Apoll011/LIC-TicketMachine/TicketMachine_LEIC23_G03.pdf

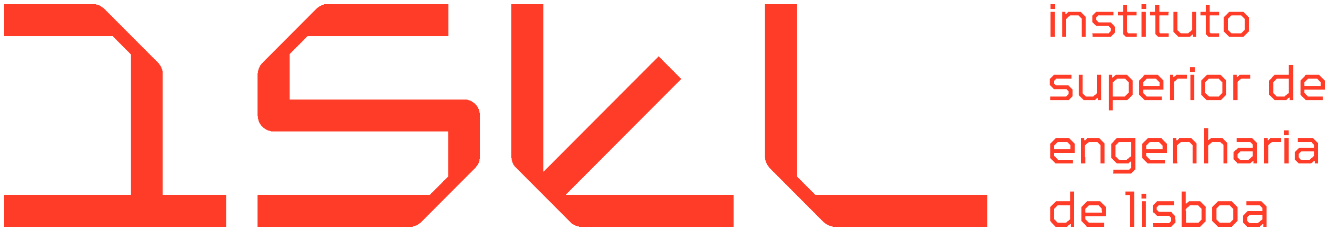
[picture p1: figure]

# Licenciatura em Engenharia Informática e de Computadores

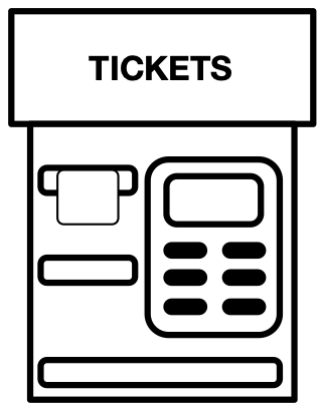
[picture p2: figure]

# MÁQUINA DE VENDA DE BILHETES

# (Ticket Machine)

## Projeto

de

## Laboratório de Informática e Computadores

## 2025 / 2026 verão

## Tiago Inês, Tiago Pedroso, Tomás Ferreira

## 05 de julho de 2026

# Conteúdo

1 Descrição | 1
2 Arquitetura do Sistema | 3
3 Resultados Experimentais | 8
4 Conclusões | 9
5 Trabalho Futuro | 9
Referências | 11
A Ticket Machine - Hardware | 12
B Ticket Machine - Software (Control) | 20

i

# Lista de Figuras

1 | Diagrama de blocos da Máquina de Venda de Bilhetes (Ticket Machine) | | 1
2 | Arquitetura do sistema que implementa a máquina de venda de bilhetes (Ticket
Machine) | | 3
3 | Diagrama de blocos do Keyboard Reader | | 4
4 | Bloco Coin Acceptor | | 5
a | Diagrama de blocos | | 5
b | Diagrama temporal | | 5
5 | Diagrama de blocos do módulo Port Expander LCD (PELCD) | | 5
6 | Diagrama de blocos do módulo Port Expander Ticket Dispenser (PETD) . . . . | 6
7 | Diagrama lógico da Máquina de Venda de Bilhetes (Ticket Machine) | | 6

# Lista de Tabelas

1 | Codificação do valor facial das moedas | | 5
2 | Atribuição de pinos do ficheiro TicketMachine.vhd [4] | | 17
3 | Atribuição de variáveis para o USBPort | | 19

# Lista de Algoritmos

1 | Ticket Machine Main Module | | 12
2 | Ticket Machine Application | | 20
3 | TUI | | 28
4 | Coin Acceptor | | 36
5 | Coin Deposit | | 37
6 | Stations | | 38
7 | File Access | | 38

ii

Laboratório de Informática e Computadores 2025/2026 verão Máquina de Venda de Bilhetes (Ticket Machine)

# 1 Descrição

## Este projeto implementa uma máquina de venda de bilhetes (Ticket Machine), que permite a

aquisição de bilhetes de comboio. O percurso é definido pela estação de origem, local de compra do bilhete e pela seleção do destino digitando o identificador da estação ou através das teclas ↑ e ↓, sendo exibido no ecrã além do identificador da estação de destino o preço e o tipo de bilhete (ida ou ida/volta). A ordem de aquisição é dada através da pressão da tecla de confirmação, sendo impressa uma unidade do bilhete exibido no ecrã. A máquina não realiza trocos e só aceita

## moedas de: 0,05e; 0,10e; 0,20e; 0,50e; 1,00e; e 2,00e. Para além do modo de Dispensa, o

## sistema tem mais um modo de funcionamento designado por Manutenção, que é ativado por

## uma chave de manutenção. Este modo permite o teste da máquina de venda de bilhetes, bem

como permite iniciar e consultar os contadores de bilhetes e moedas. A máquina de venda de bilhetes é constituída pelo sistema de gestão (designado por Control na Figura 1) e pelos seguintes periféricos: um teclado de 16 teclas, um moedeiro (designado por Coin Acceptor ), um ecrã Liquid Cristal Display (LCD) de duas linhas de 16 caracteres, um mecanismo de dispensa de bilhetes (designado por Ticket Dispenser ) e uma chave de manutenção (designada por M ) que define se

## a máquina de venda de bilhetes está em modo de Manutenção, conforme o diagrama de blocos

apresentado na Figura 1.

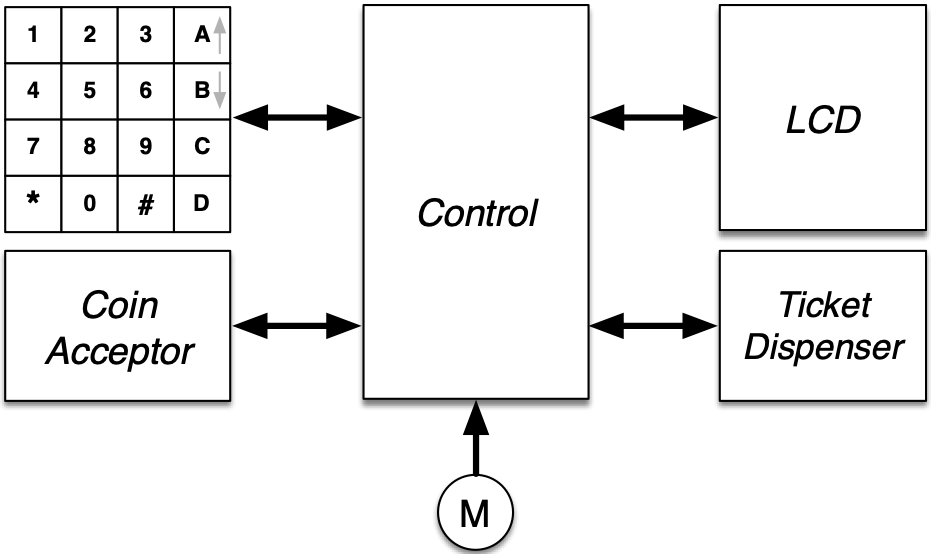
[picture p3: figure]

### Figura 1: Diagrama de blocos da Máquina de Venda de Bilhetes (Ticket Machine)

## Sobre o sistema podem-se realizar as seguintes ações em modo Venda:

## - Consulta e venda A consulta de um bilhete é realizada digitando o identificador da

estação de destino ou listando-a através das teclas ↑ e ↓. O processo de compra do bilhete inicia-se premindo a tecla ‘#’. Durante a inserção do respetivo valor monetário, é possível alterar o tipo de bilhete (ida ou ida/volta) premindo a tecla ‘∗’, com a consequente alteração

## do preço da viagem afixado no LCD, duplicando o valor no caso de ida/volta. Durante a

## compra ficam afixados no LCD as informações referentes ao bilhete pretendido até que o

## mecanismo de impressão de bilhetes confirme que a impressão já foi realizada e a recolha

## do bilhete efetuada. A compra pode ser cancelada premindo a tecla ‘#’, devolvendo as

moedas inseridas.

1

## Sobre o sistema podem-se realizar as seguintes ações em modo Manutenção:

## - Teste – Esta opção do menu permite realizar um procedimento de consulta e venda de

## um bilhete, sem introdução de moedas e sem esta operação ser contabilizada como uma

aquisição.

- Consulta Bilhetes – Premindo a tecla ’A’, em seguida através das teclas ↑ e ↓, visualizam os contadores do número de bilhetes vendidos.

## - Consulta Moedas – Premindo a tecla ’B’, em seguida através das teclas ↑ e ↓, visualizam

os contadores das moedas no cofre.

## - Iniciar os contadores de moedas e bilhetes – Premindo a tecla ’C’ e em seguida a

tecla ’∗’, o sistema de gestão coloca os contadores de moedas e bilhetes a zero, iniciando um novo ciclo de contagem.

## - Desligar – Premindo a tecla ’D’ permite desligar o sistema, que encerra apenas após a

## confirmação do utilizador, ou seja, o programa termina e as estruturas de dados, contendo

## a informação dos contadores de moedas e da lista de bilhetes vendidos, são armazena-

## das de forma persistente em dois ficheiros de texto. A informação em cada ficheiros deve

## estar organizada por linha, em que os campos de dados são separados por “;”, com o respe-

## tivo formato: ’COIN_V ALUE; NUMBER_COINS’ (valor facial; número de moedas) e

## ’P RICE; SOLD_T ICKET S; ST AT ION_NAME’ (preço; número de bilhetes vendidos

## para a estação; nome da estação). Os dois ficheiros devem ser carregados para o sistema

no seu processo de arranque.

Nota: A inserção de informação através do teclado tem o seguinte critério: i) se não for premida

## nenhuma tecla num intervalo de cinco segundos o comando em curso é abortado; ii) quando o

dado a introduzir é composto por mais que um dígito, são considerados apenas os últimos dígitos, a inserção realiza-se do dígito de maior peso para o de menor peso.

2

# 2 Arquitetura do Sistema

## O sistema implementa uma solução híbrida de hardware e software, como apresentado no dia-

grama de blocos da Figura 2. A arquitetura proposta é constituída por cinco módulos principais:

## i) um leitor de teclado, designado por Keyboard Reader ; ii) um módulo de interface com o

## LCD, designado por Port Expander LCD (PELCD); iii) um módulo de interface com o meca-

nismo de dispensa de bilhetes (Ticket Dispenser ), designado por Port Expander Ticket Dispenser (PETD); iv) um moedeiro, designado por Coin Acceptor ; e v) um módulo de controlo, designado por Control.
Os módulos i), ii) e iii) deverão ser implementados em hardware, o moedeiro (iv) será emu-lado utilizando quatro interruptores e três LED, enquanto o módulo de controlo (v) deverá ser implementado em software, descrito em linguagem Kotlin e executado num PC.

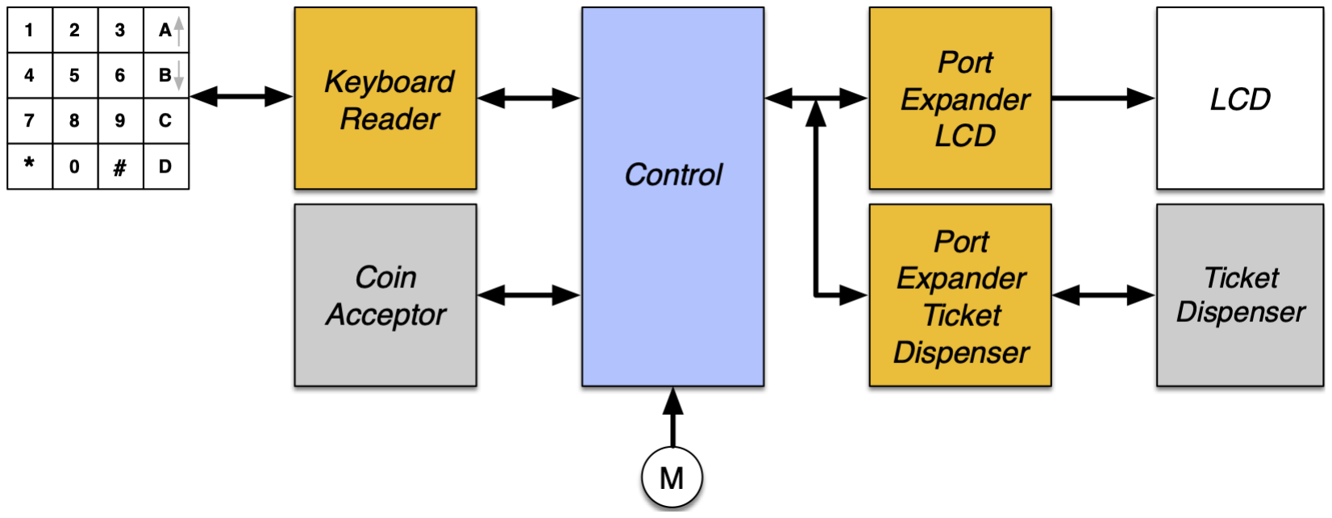
[picture p4: figure]

Figura 2: Arquitetura do sistema que implementa a máquina de venda de bilhetes (Ticket Machine)

O módulo Keyboard Reader é responsável pela descodificação do teclado matricial de 16 teclas, determinando qual a tecla pressionada e disponibilizando o seu código, com quatro bits, ao módulo Control. Caso este não esteja disponível para o receber imediatamente, o código da tecla é armazenado internamente, até ao limite de dezoito (18) códigos. O módulo Control processa os dados e envia a informação a apresentar no LCD através do módulo PELCD. O Ticket Dispenser

## é atuado pelo módulo Control, através do módulo PETD. Por forma a minimizar o número de

## interligações, a comunicação entre o módulo Control e os módulos PELCD e PETD é realizada

através de um protocolo série.

## 2.1 Keyboard Reader

O módulo Keyboard Reader [1] é constituído por três blocos principais: i) o descodificador de teclado (Key Decode); ii) o bloco de armazenamento (designado por Ring Buffer ); e iii) o bloco de entrega ao consumidor (designado por Key Transmitter ). Neste caso o módulo Control, implementado em software, é a entidade consumidora.

## 2.1.1 Ring Buffer

O bloco Ring Buffer implementa uma fila FIFO de 16 posições de 4 bits, responsável por desa-coplar o ritmo de produção de teclas (lado do Key Decode) do ritmo de consumo (lado do Key

3

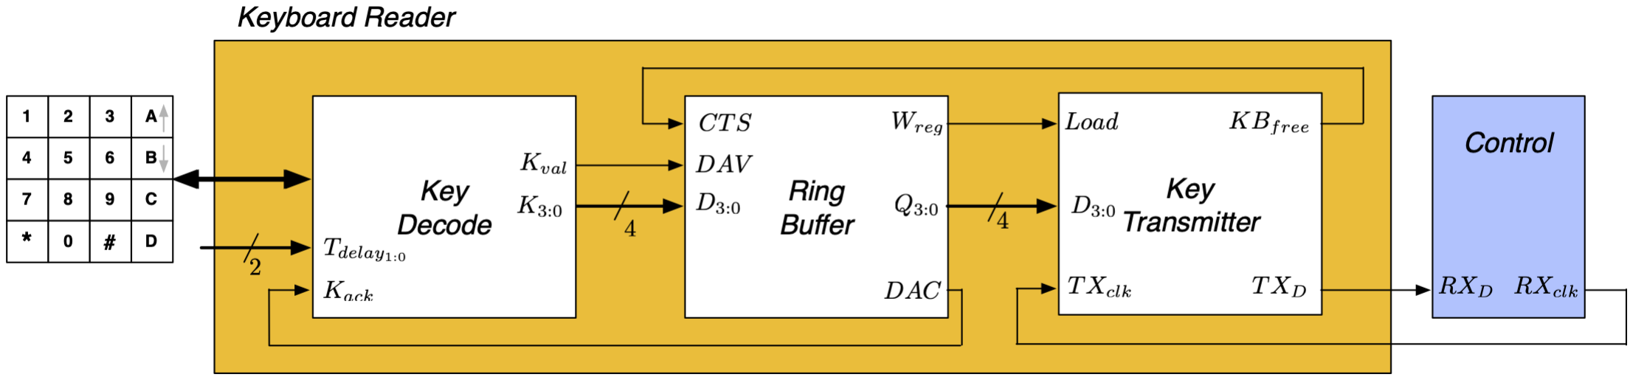
[picture p5: figure]

### Figura 3: Diagrama de blocos do Keyboard Reader

Transmitter ). A sua arquitectura, representada na Figura 3, é composta por três sub-blocos:

## - RAM — memória de 16 palavras de 4 bits, construída estruturalmente a partir de 16

registos Reg endereçados por um descodificador DecoderBuffer. A leitura é combinatória; a escrita é síncrona e controlada pelo sinal wr.

## - MAC (Memory Address Control) — mantém dois apontadores de 4 bits, putIndex (es-

## crita) e getIndex (leitura), cada um implementado com um somador e um registo. Um

## sub-bloco RAMEF conta o número de elementos presentes e gera os sinais full e empty. O

## sinal putNget selecciona, via MUX4, qual dos dois apontadores é apresentado à RAM em

cada ciclo.

## - RBC (Ring Buffer Control) — máquina de estados que arbitra o acesso à RAM entre as

operações de escrita (proveniente do Key Decode via DAV) e de leitura (solicitada pelo Key Transmitter via CTS). A escrita é confirmada ao produtor através do sinal DAC; a leitura é sinalizada ao Key Transmitter através do sinal Wreg.

O protocolo de escrita segue o handshake DAV/DAC definido no enunciado: o Key Decode activa DAV e mantém os dados estáveis; o Ring Buffer escreve em memória, activa DAC e aguarda que DAV baixe antes de regressar ao estado de espera. A leitura é iniciada pelo Key Transmitter através de CTS: o Ring Buffer coloca os dados de getIndex na saída Q, pulsa Wreg para que o Key Transmitter os latche, e incrementa getIndex.

## 2.2 Coin Acceptor

O módulo Coin Acceptor implementa a interface com o moedeiro, sinalizando ao módulo Control

## que o moedeiro recebeu uma moeda através da ativação do sinal Coin, o valor monetário da

moeda inserida é codificado em Coinid2:0 , conforme a codificação apresentada na Tabela 1. A

## entidade consumidora informa o Coin Acceptor que já contabilizou a moeda ativando o sinal

accept, conforme apresentado no diagrama temporal da Figura 4b. O Control pode devolver as moedas inseridas no moedeiro através da ativação do sinal eject durante dois segundos, ou reco-lher as moedas presentes no moedeiro através da ativação do sinal collect durante dois segundos.

4

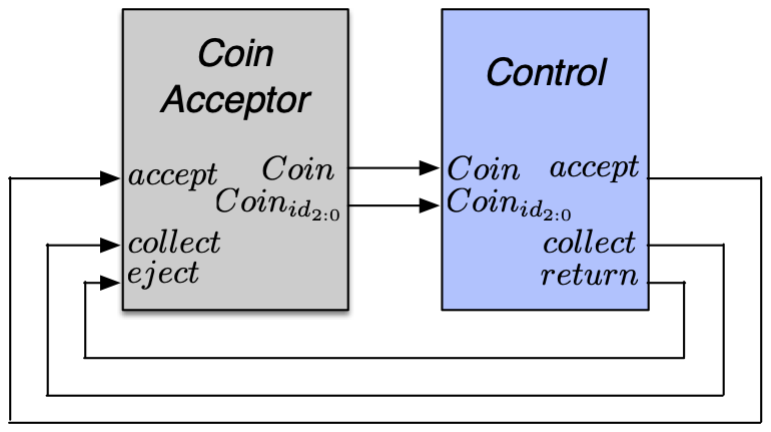
[picture p6: figure]

(a) Diagrama de blocos | (b) Diagrama temporal

### Figura 4: Bloco Coin Acceptor

### Tabela 1: Codificação do valor facial das moedas

Moeda [e] | Codificação [Cid2Cid1Cid0]
0,05 | 000
0,10 | 001
0,20 | 010
0,50 | 011
1,00 | 100
2,00 | 101

## 2.3 Port Expander LCD

## O módulo Port Expander LCD [2] (PELCD) implementa a interface com o LCD, fazendo a

receção em série da informação enviada pelo módulo de controlo e entregando-a posteriormente ao LCD, conforme representado na Figura 5.

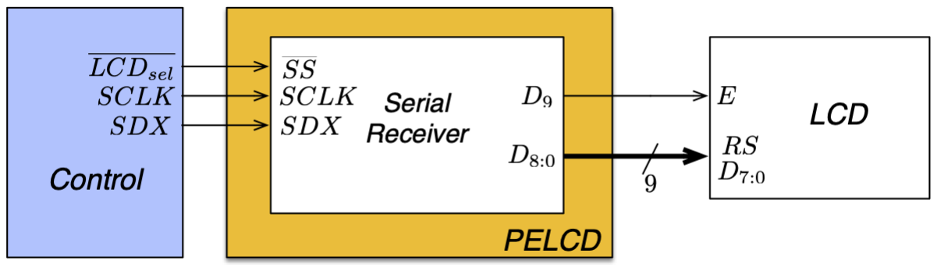
[picture p7: figure]

### Figura 5: Diagrama de blocos do módulo Port Expander LCD (PELCD)

## 2.4 Port Expander Ticket Dispenser

## O módulo Port Expander Ticket Dispenser [3] (PETD) implementa a interface com o mecanismo

de impressão de bilhetes (Ticket Dispenser ), realizando a receção em série da informação enviada

## pelo módulo de controlo e entregando-a posteriormente ao mecanismo, conforme representado

na Figura 6.

5

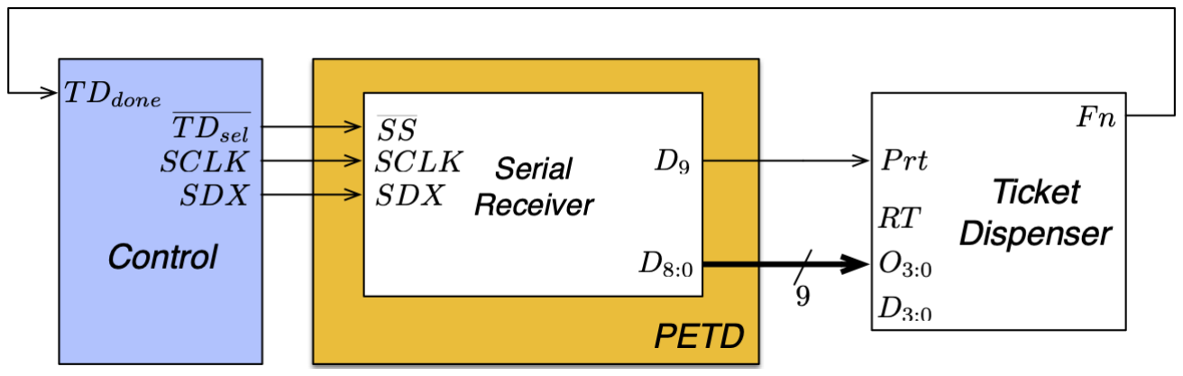
[picture p8: figure]

### Figura 6: Diagrama de blocos do módulo Port Expander Ticket Dispenser (PETD)

## 2.5 Control

## A implementação do módulo Control foi realizada em software, usando a linguagem Kotlin e

seguindo a arquitetura lógica apresentada na Figura 7.

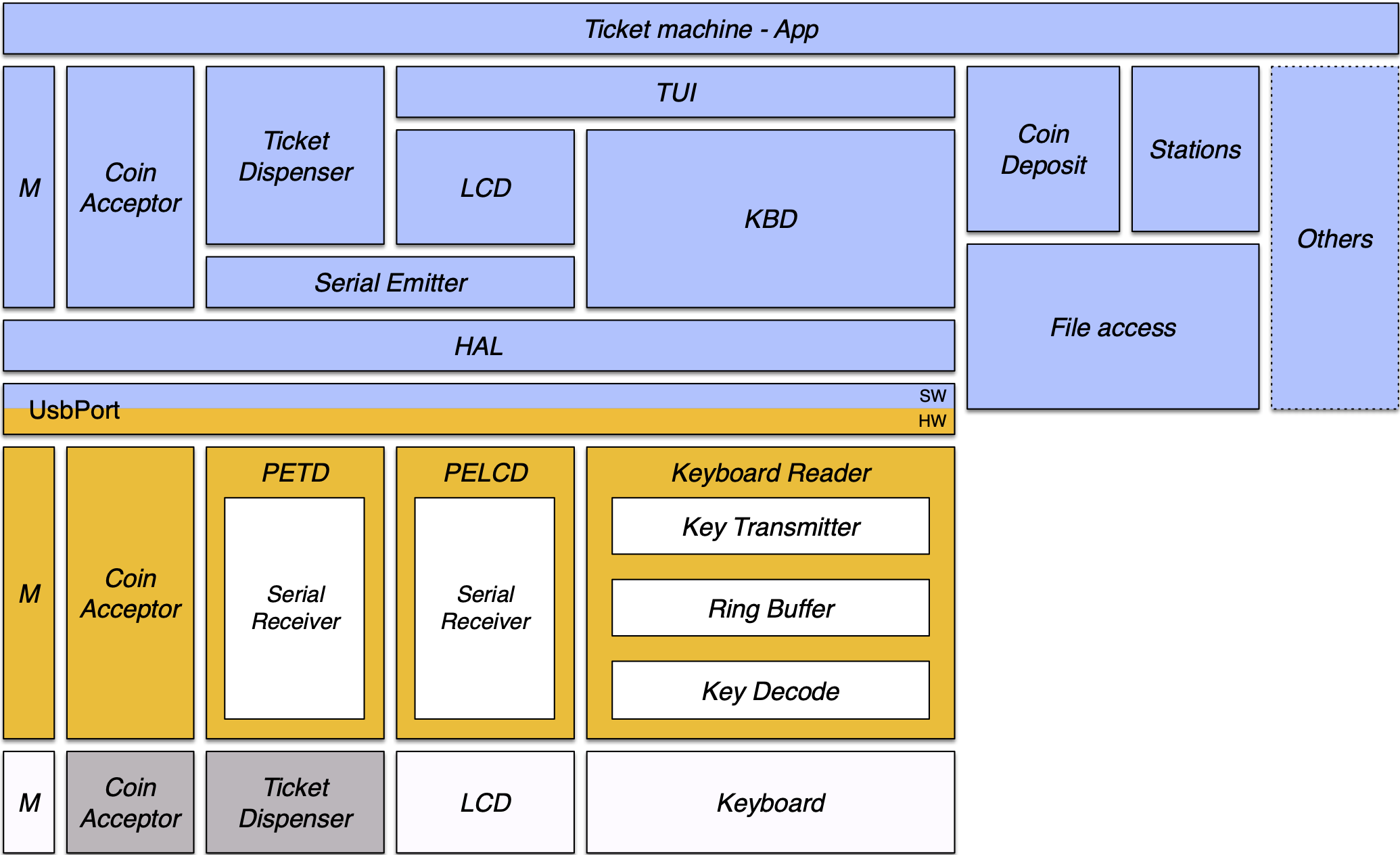
[picture p9: figure]

### Figura 7: Diagrama lógico da Máquina de Venda de Bilhetes (Ticket Machine)

## 2.5.1 Protocolo de comunicação série (software)

## A comunicação entre o módulo Control e os módulos PELCD e PETD é realizada pelo objecto

SerialEmitter, que partilha as linhas SDX (dados) e SCLK (relógio) entre os dois periféricos, diferenciando-os através de sinais de selecção independentes: SSLCD (bit 2 do output port) para o PELCD e SSTD (bit 3) para o PETD.

## O procedimento de envio de uma trama de n bits é o seguinte:

1. Desactivar SCLK e activar o slave select do periférico de destino (transição descendente em SS), assinalando o início de trama.
2. Para cada bit, do LSB para o MSB: colocar o bit em SDX, aguardar a estabilização do sinal,

## activar SCLK e desactivar SCLK. O Serial Receiver no hardware amosta SDX na transição

6

ascendente de SCLK.

## 3. Activar SS (transição ascendente), gerando a condição de fim de trama. Neste momento o

## Hold Register do Serial Receiver captura o conteúdo do Shift Register, tornando os dados

disponíveis nos periféricos.

4. Emitir um pulso de relógio adicional após a subida de SS para garantir que o Hold Register capta correctamente os dados antes que SDX mude de estado.

A trama enviada para o PELCD tem 10 bits no formato [RS, D0, D1, . . . , D7, E], sendo RS o

## primeiro bit transmitido. A trama enviada para o PETD tem igualmente 10 bits no formato

[RT, O0, O1, O2, O3, D0, D1, D2, D3, Prt], onde RT indica o tipo de bilhete (ida/ida e volta), O3:0 e D3:0 são os códigos da estação de origem e de destino, e Prt activa a impressão.
O mapeamento completo entre sinais lógicos e bits do UsbPort está detalhado na Tabela 3 do Apêndice.

7

# 3 Resultados Experimentais

A verificação do sistema foi realizada em duas fases distintas: simulação dos módulos de hardware com recurso ao ModelSim e teste do sistema completo na placa de desenvolvimento DE10-Lite, com o módulo de controlo a correr num PC via ligação USB/JTAG.

## Simulação dos módulos de hardware

Todos os módulos VHDL desenvolvidos foram verificados individualmente através de testbenches dedicados. Os módulos validados incluem os blocos combinatórios e sequenciais da biblioteca comum (FFD, Reg, RAM, AdderSubtrator, CLKDIV), o Keyboard Reader completo (Key_Scan,

## Key_Decode, KeyDecoderFSM, KeyTransmitter, RingBuffer), o módulo PELCD com o respec-

tivo SerialReceiver, e o PETD com o TICKET_DISPENSER.
Os resultados das simulações confirmaram o funcionamento correcto dos protocolos série implementados: a recepção de tramas de 10 bits no PELCD e no PETD produziu os valores esperados nos registos de saída, e o Ring Buffer respeitou a disciplina FIFO com as condições de full/empty correctamente assinaladas.

## Testes na placa

O sistema integrado foi testado na placa DE10-Lite em modo de venda e em modo de manutenção.

## As funcionalidades verificadas incluem:

- Consulta e navegação de destinos através das teclas ↑ e ↓ e por digitação directa do identificador;

## - Inserção de moedas, actualização do montante em falta no LCD e dispensa de bilhete com

activação do sinal collect;

- Cancelamento de compra com devolução das moedas via sinal eject;

## - Acesso ao modo de Manutenção pela chave M e utilização de todas as opções do menu

(Teste, Consulta Bilhetes, Consulta Moedas, Reset e Desligar);

## - Persistência de dados: os contadores de moedas e bilhetes são correctamente guardados

nos ficheiros CoinDeposit.txt e stations.txt e recarregados no arranque seguinte.

8

# 4 Conclusões

O trabalho consistiu no desenvolvimento de uma máquina de venda de bilhetes de comboio,

## implementada numa solução híbrida de hardware e software. A componente de hardware foi

## descrita em VHDL e sintetizada na placa DE10-Lite (FPGA MAX 10), englobando o Keyboard

## Reader, os módulos PELCD e PETD, o Ticket Dispenser e o Coin Acceptor. A componente de

software foi desenvolvida em Kotlin e executada num PC, comunicando com o hardware através da porta virtual JTAG/USB.

## Os resultados experimentais confirmam o funcionamento do sistema em ambos os modos de

## operação definidos no enunciado — modo de Venda e modo de Manutenção — com excepção da

anomalia esporádica no leitor de teclado descrita na secção anterior.
Do ponto de vista das aprendizagens, o projecto foi particularmente relevante em dois domínios:

## Integração hardware/software. A necessidade de coordenar sinais com semântica de nível

(Kval) com protocolos orientados a pulsos (Load/KBfree) evidenciou a importância de uma espe-cificação rigorosa das interfaces entre os dois domínios. A introdução do módulo KeyInterface,

## que resolve o deadlock de handshake entre o Key_Decode e o KeyTransmitter, ilustra como

problemas de integração surgem frequentemente nas fronteiras entre blocos, mesmo quando cada bloco individualmente está correcto.

## Arquitectura em camadas (HAL/TUI ). A separação entre a camada de abstracção de

hardware (HAL), a camada de interface série (SerialEmitter), os periféricos lógicos (LCD, KBD, CoinAcceptor, TicketDispenser) e a lógica aplicacional (App) permitiu desenvolver e testar

## cada módulo de forma independente, reduzindo significativamente o esforço de depuração na

fase de integração. Esta organização, semelhante à de sistemas embebidos reais, demonstrou o valor prático de uma arquitectura em camadas mesmo em projectos de dimensão académica.

# 5 Trabalho Futuro

## No âmbito do desenvolvimento futuro da máquina de venda de bilhetes, existem diversas me-

lhorias que poderiam ser implementadas de forma a enriquecer a experiência do utilizador e aumentar a funcionalidade do sistema.
Uma das melhorias mais relevantes seria a implementação de um sistema de histórico das últimas compras realizadas. Esta funcionalidade permitiria que no modo de manutenção podessemos ver o histórico das últimas viagens, mostrando informações como a estação de destino, o tipo de bilhete adquirido (ida ou ida/volta) e o valor pago. Este histórico poderia ser armazenado de forma persistente num ficheiro de texto, seguindo a mesma abordagem já utilizada para os contadores de moedas e bilhetes, sendo carregado no arranque do sistema e atualizado a cada nova compra.
Outra melhoria significativa seria a implementação de um sistema de troco automático. Atual-mente, a máquina não realiza trocos, o que obriga o utilizador a inserir o valor exato do bilhete. Com esta funcionalidade, o sistema calcularia automaticamente a diferença entre o valor inserido e o preço do bilhete, devolvendo o troco ao utilizador através do mecanismo de ejeção de moedas

9

já existente.
Por fim, uma melhoria igualmente importante seria o suporte a notas, nomeadamente notas de 5€ e 10€. Dado que no trabalho não utilzamos o espaço da lista do coinId referente ao 110 e ao 111 nos switches SW2, SW3 e SW4 respetivamente, seria apenas possível adicionar mais estas duas notas.

10

# Referências

[1] David Velez, Nuno Sebastião, Pedro Miguens Matutino, Rogério Rebelo, Rui Duarte KeyBoardReader datasheet, 2026, ISEL.

## [2] David Velez, Nuno Sebastião, Pedro Miguens Matutino, Rogério Rebelo, Rui Duarte Port

Expander LCD datasheet, 2026, ISEL.

## [3] David Velez, Nuno Sebastião, Pedro Miguens Matutino, Rogério Rebelo, Rui Duarte Port

Expander Ticket Dispenser datasheet, 2026, ISEL.

[4] Terasic DE10-lite User Manual, 2020, Terasic.

## [5] Terasic de10-Lite Exp. Board - Reference Manual, 2022, Pedro Miguens Matutino

## [6] David Velez, Nuno Sebastião, Pedro Miguens Matutino, Rogério Rebelo, Rui Duarte Enun-

ciado TicketMachine, 2026, ISEL.

[7] David Velez, Nuno Sebastião, Pedro Miguens Matutino, Rogério Rebelo, Rui Duarte Moodle LIC, 2026, ISEL.

11

# A Ticket Machine - Hardware

## A.1 TicketMachine.vhd

O ficheiro TicketMachine.vhd constitui o módulo de topo (top-level) do sistema de hardware. A sua função é exclusivamente estrutural: instancia todos os módulos de hardware e estabelece as ligações entre eles e com os pinos físicos da placa DE10-Lite.

## Os módulos instanciados e as suas interligações principais são os seguintes:

## - UsbPort — ponte virtual JTAG que expõe um input port de 8 bits (lido pelo software) e

## um output port de 8 bits (escrito pelo software). O mapeamento de bits está descrito na

Tabela 3.

- KeyboardReader — recebe as linhas do teclado matricial (Keys_Vertical/Keys_Horizontal), o relógio de transmissão série TXclk (bit 7 do output port) e expõe TXD (bit 7 do input port) com o código da tecla serializado.

## - PELCD — recebe SDX (bit 0), SCLK (bit 1) e SSLCD (bit 2) do output port; a sua saída de

## 10 bits é desdobrada directamente nos sinais LCD_RS, LCD_DATA[7:0] e LCD_EN ligados ao

LCD da placa.

## - PETD — partilha SDX e SCLK com o PELCD; o seu slave select é SSTD (bit 3). A saída de

10 bits é mapeada em RT, D[7:0] e Prt, que alimentam o TICKET_DISPENSER.

## - TICKET_DISPENSER — recebe RT, Prt, os nibbles de origem (O[3:0]) e destino (D[3:0]) e

## o sinal de recolha do bilhete CollectTicket (interruptor SW); produz o sinal Fn (bit 4 do

input port) e conduz os seis displays de 7 segmentos HEX0–HEX5.

## - CoinAcceptor — lê os interruptores Coin e CId[2:0] e os comandos accept/eject/collect

dos bits 4, 5 e 6 do output port; acciona os LEDs homónimos na placa.

O sinal de manutenção M (interruptor SW, bit 6 do input port) é ligado directamente ao input port sem qualquer lógica adicional em hardware, sendo interpretado exclusivamente pelo software.

### Algoritmo 1: Ticket Machine Main Module

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

12

19 | Coin | : i n | s t d_ l o g i c ;
20 | CId | : i n | s t d_ l o g i c_ v e c t o r ( 2 downto 0 ) ;
21
22 | Accept | : out s t d_ l o g i c ;
23 | E j e c t | : out s t d_ l o g i c ;
24 | C o l l e c t | : out s t d_ l o g i c ;
25
26 | M | : i n s t d_ l o g i c ;
27
28 | HEX0 , HEX1 , HEX2 , HEX3 , HEX4 , HEX5 : out s t d_ l o g i c_ v e c t o r ( 7 downto 0 )
29 | ) ;
30 | end e n t i t y T i ck etMa ch in e ;
31
32 a r c h i t e c t u r e l o g i c F u n c t i o n o f T i ck etMa ch in e i s
33
34 | −− −−−−−−−−−−−−−−−−−−−−−−−−−−−−−−−−−−−−−−−−−−−−−−−−−−−−−−−−
35 | −− Component d e c l a r a t i o n s
36 | −− −−−−−−−−−−−−−−−−−−−−−−−−−−−−−−−−−−−−−−−−−−−−−−−−−−−−−−−−
37
38 | component KeyboardReader i s
39 | p o r t (
40 | CLK | : i n | s t d_ l o g i c ;
41 | RESET | : i n | s t d_ l o g i c ;
42 | Tde lay | : i n | s t d_ l o g i c_ v e c t o r ( 1 downto 0 ) ;
43 | K ey s_V e r t i c a l | : out s t d_ l o g i c_ v e c t o r ( 3 downto 0 ) ;
44 | K eys_Hor i zonta l | : i n | s t d_ l o g i c_ v e c t o r ( 3 downto 0 ) ;
45 | TXclk | : i n | s t d_ l o g i c ;
46 | TXD, c lk_out , c l k_ ou t_ r i s e : out s t d_ l o g i c
47 | ) ;
48 | end component KeyboardReader ;
49
50 | component UsbPort i s
51 | p o r t (
52 | i n p u tP o r t | : i n | s t d_ l o g i c_ v e c t o r ( 7 downto 0 ) ;
53 | ou tpu tPo r t : out s t d_ l o g i c_ v e c t o r ( 7 downto 0 )
54 | ) ;
55 | end component UsbPort ;
56
57 | component PELCD i s
58 | p o r t (
59 | SDX, CLK, SS , RESET : i n | s t d_ l o g i c ;
60 | Q | : out s t d_ l o g i c_ v e c t o r ( 9 downto 0 )
61 | ) ;
62 | end component PELCD ;
63
64 | component PETD i s
65 | p o r t (
66 | SDX, CLK, SS , RESET : i n | s t d_ l o g i c ;
67 | D | : out s t d_ l o g i c_ v e c t o r ( 7 downto 0 ) ;
68 | Prt , Rt | : out s t d_ l o g i c
69 | ) ;
70 | end component PETD ;
71
72 | component TICKET_DISPENSER i s
73 | p o r t (
74 | RT, Prt , C o l l e c t T i c k e t | : i n | s t d_ l o g i c ;
75 | O, D | : i n | s t d_ l o g i c_ v e c t o r ( 3 downto 0 ) ;
76 | Fn | : out s t d_ l o g i c ;
77 | HEX0 , HEX1 , HEX2 , HEX3 , HEX4 , HEX5 : out s t d_ l o g i c_ v e c t o r ( 7 downto 0 )
78 | ) ;
79 | end component TICKET_DISPENSER ;
80
81 | component Co inA c c eptor i s
82 | p o r t (

13

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

14

147 | −− KeyboardReader | no e x t e r n a l w i r i n g needed .
148 | −−
149 | −− Note : i f your KeyboardReader d o e s not exp o s e Kval/K a s
150 | −− top−l e v e l p o r t s , move t h o s e s i g n a l s back h e r e and w i r e
151 | −− Kack from a l o c a l KBfree s i g n a l i n s t e a d .
152 | −− −−−−−−−−−−−−−−−−−−−−−−−−−−−−−−−−−−−−−−−−−−−−−−−−−−−−−−−−
153 | KBD: component KeyboardReader
154 | p o r t map (
155 | | CLK | | => CLK,
156 | | RESET | | => RESET,
157 | | Tde lay | | => Tde lay ,
158 | K ey s_V e r t i c a l | => K eys_V ert i ca l ,
159 | K eys_Hor i zonta l => Keys_Hor izonta l ,
160 | | TXclk | | => TXclk ,
161 | | TXD | | => TXD,
162 | | c lk_out | | => c lk_out ,
163 | c l k_ o u t_ r i s e | => c l k_ o u t_ r i s e
164 | ) ;
165
166 | −− −−−−−−−−−−−−−−−−−−−−−−−−−−−−−−−−−−−−−−−−−−−−−−−−−−−−−−−−
167 | −− LCD s e r i a l d e c od e r
168 | −− S o f tw a r e d r i v e s SDX/CLK/SS v i a output p o r t b i t s 0 , 1 , 2
169 | −− OUTPUT_PORT_LINK b i t a s s i gnm en t ( s e t by s o f t w a r e ) :
170 | −− | [ 0 ] = SDX | ( s e r i a l data )
171 | −− | [ 1 ] = CLK | ( s e r i a l c l o c k )
172 | −− | [ 2 ] = SS | (LCD s l a v e s e l e c t )
173 | −− | [ 3 ] = SS | ( t i c k e t s l a v e s e l e c t )
174 | −− | [ 7 ] = Kack ( key a cknow l edg e | on l y us ed i n o l d d e s i gn ,
175 | −− | | | now hand l ed i n t e r n a l l y by KeyboardReader )
176 | −− −−−−−−−−−−−−−−−−−−−−−−−−−−−−−−−−−−−−−−−−−−−−−−−−−−−−−−−−
177 | LCD_SERIAL : component PELCD
178 | p o r t map (
179 | | RESET | | => RESET,
180 | | CLK | | => OUTPUT_PORT_LINK( 1 ) ,
181 | | SDX | | => OUTPUT_PORT_LINK( 0 ) ,
182 | | SS | | => OUTPUT_PORT_LINK( 2 ) ,
183 | | Q | | => LCD_FRAME_LINK
184 | ) ;
185
186 | −− LCD frame b i t a s s i gnm en t ( matches o r i g i n a l ) :
187 | −− | Q[ 9 ] | = RS | ( r e g i s t e r s e l e c t )
188 | −− | Q[ 8 : 1 ] = DATA ( data byte , b i t 0 f i r s t i n frame = Q[ 8 ] = DATA[ 0 ] )
189 | −− | Q[ 0 ] | = E | ( e n a b l e s t r o b e )
190 | LCD_RS | <= LCD_FRAME_LINK( 9 ) ;
191 | LCD_DATA( 0 ) | <= LCD_FRAME_LINK( 8 ) ;
192 | LCD_DATA( 1 ) | <= LCD_FRAME_LINK( 7 ) ;
193 | LCD_DATA( 2 ) | <= LCD_FRAME_LINK( 6 ) ;
194 | LCD_DATA( 3 ) | <= LCD_FRAME_LINK( 5 ) ;
195 | LCD_DATA( 4 ) | <= LCD_FRAME_LINK( 4 ) ;
196 | LCD_DATA( 5 ) | <= LCD_FRAME_LINK( 3 ) ;
197 | LCD_DATA( 6 ) | <= LCD_FRAME_LINK( 2 ) ;
198 | LCD_DATA( 7 ) | <= LCD_FRAME_LINK( 1 ) ;
199 | LCD_EN | <= LCD_FRAME_LINK( 0 ) ;
200
201 | −− −−−−−−−−−−−−−−−−−−−−−−−−−−−−−−−−−−−−−−−−−−−−−−−−−−−−−−−−
202 | −− T i c k e t s e r i a l d e c od e r
203 | −− Same SDX/CLK l i n e s a s LCD, d i f f e r e n t s l a v e s e l e c t ( b i t 3 )
204 | −− −−−−−−−−−−−−−−−−−−−−−−−−−−−−−−−−−−−−−−−−−−−−−−−−−−−−−−−−
205 | TICKET_SERIAL : component PETD
206 | p o r t map (
207 | | RESET | | => RESET,
208 | | CLK | | => OUTPUT_PORT_LINK( 1 ) ,
209 | | SDX | | => OUTPUT_PORT_LINK( 0 ) ,
210 | | SS | | => OUTPUT_PORT_LINK( 3 ) ,

15

211 | D | => PETD_D_LINK,
212 | | Rt | => RT_LINK,
213 | | Prt | => PRT_LINK
214 | ) ;
215
216 | −− −−−−−−−−−−−−−−−−−−−−−−−−−−−−−−−−−−−−−−−−−−−−−−−−−−−−−−−−
217 | −− T i c k e t d i s p e n s e r FSM + 7−segment d i s p l a y d r i v e r s
218 | −− PETD_D_LINK byt e l a y o u t ( s e t by s o f t w a r e v i a PETD) :
219 | −− | [ 3 . . 0 ] = O | ( t i c k e t o p t i o n / q u a n t i t y low n i b b l e )
220 | −− | [ 7 . . 4 ] = D | ( t i c k e t d e s t i n a t i o n / q u a n t i t y h i gh n i b b l e )
221 | −− −−−−−−−−−−−−−−−−−−−−−−−−−−−−−−−−−−−−−−−−−−−−−−−−−−−−−−−−
222 | TICKET_DISP : component TICKET_DISPENSER
223 | p o r t map (
224 | | RT | => RT_LINK,
225 | | Prt | => PRT_LINK,
226 | | C o l l e c t T i c k e t | => C o l l e c t T i c k e t ,
227 | O | => PETD_D_LINK( 3 downto 0 ) ,
228 | D | => PETD_D_LINK( 7 downto 4 ) ,
229 | | Fn | => FN_LINK,
230 | | HEX0 | => HEX0 ,
231 | | HEX1 | => HEX1 ,
232 | | HEX2 | => HEX2 ,
233 | | HEX3 | => HEX3 ,
234 | | HEX4 | => HEX4 ,
235 | | HEX5 | => HEX5
236 | ) ;
237
238 | −− Coin A c c ep to r
239 | COIN_ACCEPTOR: component Co inA c c eptor
240 | p o r t map (
241 | | Coin | => Coin ,
242 | | CId | => CId ,
243 | | C o i n I n p u tB i t s | => COIN_INPUT_LINK,
244 | | AcceptCmd | => OUTPUT_PORT_LINK( 4 ) ,
245 | | EjectCmd | => OUTPUT_PORT_LINK( 5 ) ,
246 | | Co l lectCmd | => OUTPUT_PORT_LINK( 6 ) ,
247 | | Accept | => Accept ,
248 | | E j e c t | => E j e c t ,
249 | | C o l l e c t | => C o l l e c t
250 | ) ;
251
252 | INPUT_PORT_LINK( 6 ) <= M;
253
254 | end a r c h i t e c t u r e l o g i c F u n c t i o n ;
A.2 | Atribuição de Pinos

16

Clock | pino
CLK | P11
Swiches | pino
Tdelay[0] Tdelay[1] CId[0] CId[1] CId[2] Coin CollectTicket M RESET | C10 C11 D12 C12 A12 B12 A13 B14 F15
LED’s | pino
Accept Eject Collect | A8 A9 A10
4x4 Matrix Keypad | pino
Keys_Vertical[0] Keys_Vertical[1] Keys_Vertical[2] Keys_Vertical[3] Keys_Horizontal[0] Keys_Horizontal[1] Keys_Horizontal[2] Keys_Horizontal[3] | AB11 AB10 AA9 AA8 W5 AA14 W12 AB12
LCD – 8-bit parallel + RS + EN | pino
LCD_RS LCD_EN LCD_DATA[0] LCD_DATA[1] LCD_DATA[2] LCD_DATA[3] LCD_DATA[4] LCD_DATA[5] LCD_DATA[6] LCD_DATA[7] | W8 V5 AA15 W13 AB13 Y11 W11 AA10 Y8 Y7

### Tabela 2: Atribuição de pinos do ficheiro TicketMachine.vhd [4]

17

HEX | Pino
HEX0[0] | C14
HEX0[1] | E15
HEX0[2] | C15
HEX0[3] | C16
HEX0[4] | E16
HEX0[5] | D17
HEX0[6] | C17
HEX0[7] | D15
HEX1[0] | C18
HEX1[1] | D18
HEX1[2] | E18
HEX1[3] | B16
HEX1[4] | A17
HEX1[5] | A18
HEX1[6] | B17
HEX1[7] | A16
HEX2[0] | B20
HEX2[1] | A20
HEX2[2] | B19
HEX2[3] | A21
HEX2[4] | B21
HEX2[5] | C22
HEX2[6] | B22
HEX2[7] | A19
HEX | Pino
HEX3[0] | F21
HEX3[1] | E22
HEX3[2] | E21
HEX3[3] | C19
HEX3[4] | C20
HEX3[5] | D19
HEX3[6] | E17
HEX3[7] | D22
HEX4[0] | F18
HEX4[1] | E20
HEX4[2] | E19
HEX4[3] | J18
HEX4[4] | H19
HEX4[5] | F19
HEX4[6] | F20
HEX4[7] | F17
HEX5[0] | J20
HEX5[1] | K20
HEX5[2] | L18
HEX5[3] | N18
HEX5[4] | M20
HEX5[5] | N19
HEX5[6] | N20
HEX5[7] | L19

### Tabela 2: Atribuição de pinos do ficheiro TicketMachine.vhd (continuação)

18

A.3 | Atribuição do USBPort
Import | pino
CoinId(0) CoinId(1) CoinId(2) Coin Fn - I5 M TXd | I0 I1 I2 I3 I4 I6 I7
Outport | pino
SDX SCLK SSLCD SSTD accept eject collect TXclk | O0 O1 O2 O3 O4 O5 O6 O7

### Tabela 3: Atribuição de variáveis para o USBPort

19

# B Ticket Machine - Software (Control)

## B.1 Ticket Machine - App

### Algoritmo 2: Ticket Machine Application

1 | import j a v a . t im e . Loca lDateT ime
2 | import j a v a . t im e . format . DateT imeFormatter
3
4 | pr ivate const va l STATION_COUNT = 16
5 | pr ivate const va l DIGIT_TIMEOUT_MS = 500L
6 | pr ivate const va l ABORT_DISPLAY_MS = 2000L
7 | pr ivate const va l THANK_YOU_DISPLAY_MS = 5000L
8 | pr ivate const va l DATE_FORMAT = " dd / MM / y y y y ␣ HH : mm "
9 | pr ivate const va l LCD_WIDTH = 16
10 | pr ivate const va l M_MASK = 0b01000000
11
12 pr ivate const va l MAINT_SCROLL_MS = 1000L 13
14 c l a s s App {
15
16 | pr ivate var c u r r e n tD e s t i n y = 0
17
18 | fun i n i t ( ) {
19 | TUI . i n i t ( )
20 | T i c k e tD i s p e n s e r . i n i t ( )
21 | S t a t i o n s . i n i t ( )
22 | Co inA c c eptor . i n i t ( )
23 | }
24
25 | fun s t a r t ( ) {
26 | while ( true ) {
27 | i f (HAL. i s B i t (M_MASK) ) {
28 | maintenanceMode ( )
29 | } e l s e {
30 | sh owSp l a shS c r e en ( )
31 | c u r r e n tD e s t i n y = 0
32 | l i s t D e s t i n a t i o n s ( )
33 | }
34 | }
35 | }
36
37 | pr ivate fun maintenanceMode ( ) {
38 | va l menuItems = l i s t O f (
39 | " # - P r i n t ␣ t i c k e t " ,
40 | "A - S t a t i o n ␣ C o u n t " ,
41 | "B - C o i n ␣ C o u n t " ,
42 | "C - S y s ␣ R e s e t " ,
43 | "D - S h u t d o w n "
44 | )
45 | var i t em Ind ex = 0
46 | var l a s t S c r o l l T i m e = System . c u r r e n t T im eM i l l i s ( )
47
48 | TUI . c l e a r ( )
49 | TUI . c u r s o r ( 0 , c en t e r edP add in g ( " M a i n t e n a n c e " . l e n g t h ) )
50 | TUI . w r i t e ( " M a i n t e n a n c e " )
51 | r e n d e r S c r o l l L i n e ( menuItems [ i t em Ind ex ] )
52
53 | while (HAL. i s B i t (M_MASK) ) {
54 | va l now = System . c u r r e n t T im eM i l l i s ( )
55 | i f (now − l a s t S c r o l l T i m e >= MAINT_SCROLL_MS) {
56 | i t em Ind ex = ( i t em Ind ex + 1 ) % menuItems . s i z e
57 | r e n d e r S c r o l l L i n e ( menuItems [ i t em Ind ex ] )

20

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

21

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

22

’# ’ −> return
}
}
}

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

pr ivate va l c o i nV a l u e s = l i s t O f ( 5 , 1 0 , 2 0 , 5 0 , 1 0 0 , 2 0 0 )

pr ivate fun ma intCo inCount ers ( ) {
var id x = 0
r end e rC o inC oun t e rS c r e en ( id x )

while ( true ) {
when (TUI . getKey ( ) ) {
’A’ −> {
id x = ( id x − 1 + c o i nV a l u e s . s i z e ) % c o i nV a l u e s . s i z e r end e rC o inC oun t e rS c r e en ( id x )
}
’B’ −> {
id x = ( id x + 1 ) % c o i nV a l u e s . s i z e r end e rC o inC oun t e rS c r e en ( id x )
}
’# ’ −> return
}
}
}

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

23

247 | TUI . c l e a r ( )
248 | TUI . c u r s o r ( 0 , c en t e r edP add in g ( " R e s e t ␣ S y s t e m " . l e n g t h ) )
249 | TUI . w r i t e ( " R e s e t ␣ S y s t e m " )
250 | TUI . c u r s o r ( 1 , 0 )
251 | TUI . w r i t e ( " * ␣ -␣ Y e s ␣ ␣ O t h e r - No " )
252 | while ( true ) {
253 | when (TUI . getKey ( ) ) {
254 | ’∗ ’ −> {
255 | TUI . d e l e t e T e x t (LCD. L in e .LOWER, 0 , LCD_WIDTH − 1 )
256 | TUI . c u r s o r ( 1 , 0 )
257 | TUI . w r i t e ( " R e s e t t i n g . . . " )
258 | r e s e t ( )
259 | s l e e p ( 1 5 0 0 )
260 | }
261 | ’ \ u0000 ’ −> {}
262 | e l s e −> return
263 | }
264 | }
265
266 | }
267
268 | pr ivate fun maintShutdown ( )
269
270
271 | {
272 | TUI . c l e a r ( )
273 | TUI . c u r s o r ( 0 , c en t e r edP add in g ( " S h u t d o w n ? " . l e n g t h ) )
274 | TUI . w r i t e ( " S h u t d o w n ? " )
275 | TUI . c u r s o r ( 1 , 1 )
276 | TUI . w r i t e ( " * - Y e s / O t h e r - No " )
277
278 | while ( true ) {
279 | when (TUI . getKey ( ) ) {
280 | ’∗ ’ −> {
281 | w r i t e F i l e ( )
282 | TUI . d e l e t e T e x t (LCD. L in e .LOWER, 0 , LCD_WIDTH − 1 )
283 | TUI . c u r s o r ( 1 , 0 )
284 | TUI . w r i t e ( " S h u t t i n g ␣ d o w n . . . " )
285 | s l e e p ( 1 5 0 0 )
286 | TUI . c l e a r ( )
287 | k o t l i n . system . e x i t P r o c e s s ( 0 )
288 | }
289 | ’ \ u0000 ’ −> {}
290 | e l s e −> return
291 | }
292 | }
293 | }
294
295 | pr ivate fun sh owSp l a shS c r e en ( ) {
296 | TUI . c l e a r ( )
297 | TUI . w r i t e ( " ␣ T i c k e t ␣ to ␣ R i d e " )
298 | TUI . c u r s o r ( 1 , 0 )
299 | TUI . w r i t e ( Loca lDateT ime . now ( ) . format ( DateT imeFormatter . o f P a t t e r n (DATE_FORMAT) ) )
300 | while (TUI . getKey ( ) == ’ \ u0000 ’ && !HAL. i s B i t (M_MASK) ) {}
301 | }
302
303 | pr ivate fun l i s t D e s t i n a t i o n s ( ) {
304 | i f (HAL. i s B i t (M_MASK) ) return
305
306 | var f i r s t D i g i t : Int ? = nu l l
307 | var d i g i tT im e = 0L
308
309 | r end e rD e s t in a t i onM enu ( )
310

24

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

while ( true ) {
va l r em a in in g = p r i c e F o r ( s t a t i o n , roundTr ip ) − C o inD ep o s i t . ammoutInserted ( )

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

i f ( Co inA c c eptor . a c c ep tC o in ( ) ) {
i f ( p r i c e F o r ( s t a t i o n , roundTr ip ) − C o inD ep o s i t . ammoutInserted ( ) < 0 )
| | continue
renderRema in ingAmount ( p r i c e F o r ( s t a t i o n , roundTr ip ) − C o inD ep o s i t .
| | ammoutInserted ( ) , roundTr ip , 0 )
}
va l f = TUI . getKey ( )
when ( f ) {

25

’∗ ’ −> {
roundTr ip = ! roundTr ip
renderRema in ingAmount ( p r i c e F o r ( s t a t i o n , roundTr ip ) − C o inD ep o s i t . ammoutInserted ( ) , roundTr ip , 0 )
}
’# ’ −> {
abortV end ing ( )
return
}
}
}
}

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

Thread . s l e e p (THANK_YOU_DISPLAY_MS) }

pr ivate fun abortV end ing ( ) {
TUI . c l e a r ( )
TUI . w r i t e ( " V E N D I N G ␣ A B O R T E D " )

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

Thread . s l e e p (ABORT_DISPLAY_MS)
}

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

26

TUI . w r i t e I c o n ( I c o n s .RIGHT_PROGRESSBAR_ICON) }

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

TUI . c u r s o r ( 1 , 0 )
i f ( showId ) TUI . w r i t e ( String . format ( " % 0 2 d " , s t a t i o n . i d ) )
}

pr ivate fun renderRema in ingAmount ( r em a in in g : Int , roundTr ip : Boo lean , s t a r tC : Int = 1 ) {
TUI . c u r s o r ( 1 , s t a r tC )
TUI . w r i t e I c o n ( I c o n s .UPWARDS_ARROW)
i f ( roundTr ip ) {
TUI . w r i t e I c o n ( I c o n s .DOWNWARDS_ARROW) } e l s e {
TUI . d e l e t e T e x t (LCD. L in e .LOWER, 1 , 2 ) }
TUI . c u r s o r ( 1 , 1 1 )
TUI . w r i t e ( formatCurr en cy ( r em a in in g ) )
TUI . w r i t e I c o n ( I c o n s .EURO_SIGN)
}

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

pr ivate fun c en t e r edP add in g ( t e x t L en g th : Int ) : Int =
(LCD_WIDTH − t e x t L en g th ) . c o e r c eA t L e a s t ( 0 ) / 2

pr ivate fun formatCurr en cy ( c e n t s : Int ) : String = String . format ( " % . 2 f " , c e n t s / 1 0 0 . 0 )

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

27

495 | }
B.2 | TUI

### Algoritmo 3: TUI

1 | import j a v a . t im e . Loca lDateT ime
2 | import j a v a . t im e . format . DateT imeFormatter
3
4 | pr ivate const va l STATION_COUNT = 16
5 | pr ivate const va l DIGIT_TIMEOUT_MS = 500L
6 | pr ivate const va l ABORT_DISPLAY_MS = 2000L
7 | pr ivate const va l THANK_YOU_DISPLAY_MS = 5000L
8 | pr ivate const va l DATE_FORMAT = " dd / MM / y y y y ␣ HH : mm "
9 | pr ivate const va l LCD_WIDTH = 16
10 | pr ivate const va l M_MASK = 0b01000000
11
12 pr ivate const va l MAINT_SCROLL_MS = 1000L 13
14 c l a s s App {
15
16 | pr ivate var c u r r e n tD e s t i n y = 0
17
18 | fun i n i t ( ) {
19 | TUI . i n i t ( )
20 | T i c k e tD i s p e n s e r . i n i t ( )
21 | S t a t i o n s . i n i t ( )
22 | Co inA c c eptor . i n i t ( )
23 | }
24
25 | fun s t a r t ( ) {
26 | while ( true ) {
27 | i f (HAL. i s B i t (M_MASK) ) {
28 | maintenanceMode ( )
29 | } e l s e {
30 | sh owSp l a shS c r e en ( )
31 | c u r r e n tD e s t i n y = 0
32 | l i s t D e s t i n a t i o n s ( )
33 | }
34 | }
35 | }
36
37 | pr ivate fun maintenanceMode ( ) {
38 | va l menuItems = l i s t O f (
39 | " # - P r i n t ␣ t i c k e t " ,
40 | "A - S t a t i o n ␣ C o u n t " ,
41 | "B - C o i n ␣ C o u n t " ,
42 | "C - S y s ␣ R e s e t " ,
43 | "D - S h u t d o w n "
44 | )
45 | var i t em Ind ex = 0
46 | var l a s t S c r o l l T i m e = System . c u r r e n t T im eM i l l i s ( )
47
48 | TUI . c l e a r ( )
49 | TUI . c u r s o r ( 0 , c en t e r edP add in g ( " M a i n t e n a n c e " . l e n g t h ) )
50 | TUI . w r i t e ( " M a i n t e n a n c e " )
51 | r e n d e r S c r o l l L i n e ( menuItems [ i t em Ind ex ] )
52
53 | while (HAL. i s B i t (M_MASK) ) {
54 | va l now = System . c u r r e n t T im eM i l l i s ( )
55 | i f (now − l a s t S c r o l l T i m e >= MAINT_SCROLL_MS) {
56 | i t em Ind ex = ( i t em Ind ex + 1 ) % menuItems . s i z e

28

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

29

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

30

}
’# ’ −> return
}
}
}

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

pr ivate va l c o i nV a l u e s = l i s t O f ( 5 , 1 0 , 2 0 , 5 0 , 1 0 0 , 2 0 0 )

pr ivate fun ma intCo inCount ers ( ) {
var id x = 0
r end e rC o inC oun t e rS c r e en ( id x )

while ( true ) {
when (TUI . getKey ( ) ) {
’A’ −> {
id x = ( id x − 1 + c o i nV a l u e s . s i z e ) % c o i nV a l u e s . s i z e r end e rC o inC oun t e rS c r e en ( id x )
}
’B’ −> {
id x = ( id x + 1 ) % c o i nV a l u e s . s i z e r end e rC o inC oun t e rS c r e en ( id x )
}
’# ’ −> return
}
}
}

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

31

246 | pr ivate fun ma intSystemReset ( ) {
247 | TUI . c l e a r ( )
248 | TUI . c u r s o r ( 0 , c en t e r edP add in g ( " R e s e t ␣ S y s t e m " . l e n g t h ) )
249 | TUI . w r i t e ( " R e s e t ␣ S y s t e m " )
250 | TUI . c u r s o r ( 1 , 0 )
251 | TUI . w r i t e ( " * ␣ -␣ Y e s ␣ ␣ O t h e r - No " )
252 | while ( true ) {
253 | when (TUI . getKey ( ) ) {
254 | ’∗ ’ −> {
255 | TUI . d e l e t e T e x t (LCD. L in e .LOWER, 0 , LCD_WIDTH − 1 )
256 | TUI . c u r s o r ( 1 , 0 )
257 | TUI . w r i t e ( " R e s e t t i n g . . . " )
258 | r e s e t ( )
259 | s l e e p ( 1 5 0 0 )
260 | }
261 | ’ \ u0000 ’ −> {}
262 | e l s e −> return
263 | }
264 | }
265
266 | }
267
268 | pr ivate fun maintShutdown ( )
269
270
271 | {
272 | TUI . c l e a r ( )
273 | TUI . c u r s o r ( 0 , c en t e r edP add in g ( " S h u t d o w n ? " . l e n g t h ) )
274 | TUI . w r i t e ( " S h u t d o w n ? " )
275 | TUI . c u r s o r ( 1 , 1 )
276 | TUI . w r i t e ( " * - Y e s / O t h e r - No " )
277
278 | while ( true ) {
279 | when (TUI . getKey ( ) ) {
280 | ’∗ ’ −> {
281 | w r i t e F i l e ( )
282 | TUI . d e l e t e T e x t (LCD. L in e .LOWER, 0 , LCD_WIDTH − 1 )
283 | TUI . c u r s o r ( 1 , 0 )
284 | TUI . w r i t e ( " S h u t t i n g ␣ d o w n . . . " )
285 | s l e e p ( 1 5 0 0 )
286 | TUI . c l e a r ( )
287 | k o t l i n . system . e x i t P r o c e s s ( 0 )
288 | }
289 | ’ \ u0000 ’ −> {}
290 | e l s e −> return
291 | }
292 | }
293 | }
294
295 | pr ivate fun sh owSp l a shS c r e en ( ) {
296 | TUI . c l e a r ( )
297 | TUI . w r i t e ( " ␣ T i c k e t ␣ to ␣ R i d e " )
298 | TUI . c u r s o r ( 1 , 0 )
299 | TUI . w r i t e ( Loca lDateT ime . now ( ) . format ( DateT imeFormatter . o f P a t t e r n (DATE_FORMAT) ) )
300 | while (TUI . getKey ( ) == ’ \ u0000 ’ && !HAL. i s B i t (M_MASK) ) {}
301 | }
302
303 | pr ivate fun l i s t D e s t i n a t i o n s ( ) {
304 | i f (HAL. i s B i t (M_MASK) ) return
305
306 | var f i r s t D i g i t : Int ? = nu l l
307 | var d i g i tT im e = 0L
308
309 | r end e rD e s t in a t i onM enu ( )

32

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

while ( true ) {
va l r em a in in g = p r i c e F o r ( s t a t i o n , roundTr ip ) − C o inD ep o s i t . ammoutInserted ( )

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

i f ( Co inA c c eptor . a c c ep tC o in ( ) ) {
i f ( p r i c e F o r ( s t a t i o n , roundTr ip ) − C o inD ep o s i t . ammoutInserted ( ) < 0 )
| | continue
renderRema in ingAmount ( p r i c e F o r ( s t a t i o n , roundTr ip ) − C o inD ep o s i t .
| | ammoutInserted ( ) , roundTr ip , 0 )
}
va l f = TUI . getKey ( )

33

when ( f ) {
’∗ ’ −> {
roundTr ip = ! roundTr ip
renderRema in ingAmount ( p r i c e F o r ( s t a t i o n , roundTr ip ) − C o inD ep o s i t . ammoutInserted ( ) , roundTr ip , 0 )
}
’# ’ −> {
abortV end ing ( )
return
}
}
}
}

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

Thread . s l e e p (THANK_YOU_DISPLAY_MS) }

pr ivate fun abortV end ing ( ) {
TUI . c l e a r ( )
TUI . w r i t e ( " V E N D I N G ␣ A B O R T E D " )

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

Thread . s l e e p (ABORT_DISPLAY_MS)
}

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

34

}
TUI . w r i t e I c o n ( I c o n s .RIGHT_PROGRESSBAR_ICON) }

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

TUI . c u r s o r ( 1 , 0 )
i f ( showId ) TUI . w r i t e ( String . format ( " % 0 2 d " , s t a t i o n . i d ) )
}

pr ivate fun renderRema in ingAmount ( r em a in in g : Int , roundTr ip : Boo lean , s t a r tC : Int = 1 ) {
TUI . c u r s o r ( 1 , s t a r tC )
TUI . w r i t e I c o n ( I c o n s .UPWARDS_ARROW)
i f ( roundTr ip ) {
TUI . w r i t e I c o n ( I c o n s .DOWNWARDS_ARROW) } e l s e {
TUI . d e l e t e T e x t (LCD. L in e .LOWER, 1 , 2 ) }
TUI . c u r s o r ( 1 , 1 1 )
TUI . w r i t e ( formatCurr en cy ( r em a in in g ) )
TUI . w r i t e I c o n ( I c o n s .EURO_SIGN)
}

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

pr ivate fun c en t e r edP add in g ( t e x t L en g th : Int ) : Int =
(LCD_WIDTH − t e x t L en g th ) . c o e r c eA t L e a s t ( 0 ) / 2

pr ivate fun formatCurr en cy ( c e n t s : Int ) : String = String . format ( " % . 2 f " , c e n t s / 1 0 0 . 0 )

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

35

494 | }
495 | }
B.3 | Coin Acceptor

### Algoritmo 4: Coin Acceptor

1 import j a v a . l a n g . Thread
2
3 | object Co inA c c eptor {
4 | pr ivate const va l CID_MASK | = 0b00000111
5 | pr ivate const va l COIN_MASK = 0b00001000
6
7 | pr ivate const va l COIN_EJECT_MASK | = 0b00100000
8 | pr ivate const va l COIN_COLLECT_MASK = 0b01000000
9 | pr ivate const va l COIN_ACCEPT_MASK | = 0b00010000
10
11 | va l co inCod e_L ist : L i s t <Int> = l i s t O f ( 5 , 1 0 , 2 0 , 5 0 , 1 0 0 , 2 0 0 , 0 , 0 )
12
13 | fun i n i t ( ) {
14 | C o inD ep o s i t . i n i t ( )
15 | HAL. c l r B i t s (COIN_ACCEPT_MASK)
16 | HAL. c l r B i t s (COIN_EJECT_MASK)
17 | HAL. c l r B i t s (COIN_COLLECT_MASK)
18 | }
19
20 | fun hasCo in ( ) : Boo l ean {
21 | return HAL. i s B i t (COIN_MASK)
22 | }
23
24 | fun getCo inID ( ) : Int ? {
25 | i f ( hasCo in ( ) ) {
26 | va l v a l u e = HAL. r e a d B i t s (CID_MASK)
27
28 | i f ( v a l u e in 0 u n t i l 6 ) {
29 | return co inCod e_L ist [ v a l u e ]
30 | }
31 | }
32
33 | return nu l l
34 | }
35
36 | fun a c c ep tC o in ( ) : Boo l ean {
37 | i f ( hasCo in ( ) ) {
38 | va l c = getCo inID ( )
39 | HAL. s e t B i t s (COIN_ACCEPT_MASK)
40
41 | i f ( c != nu l l ) C o inD ep o s i t . add ( c )
42 | while ( hasCo in ( ) ) ;
43
44 | HAL. c l r B i t s (COIN_ACCEPT_MASK)
45 | return true
46 | }
47 | return f a l s e
48 | }
49
50 | fun e j e c t C o i n s ( ) {
51 | HAL. s e t B i t s (COIN_EJECT_MASK)
52 | C o inD ep o s i t . e j e c t I n s e r t e d C o i n s ( )
53 | Thread . s l e e p ( 2 0 0 0L)
54 | HAL. c l r B i t s (COIN_EJECT_MASK)
55 | }

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

## B.4 Coin Deposit

### Algoritmo 5: Coin Deposit

data c l a s s Coin ( va l typ e : Int , var cu r r en tC oun t : Int , va l i d : Int )

object C o inD ep o s i t {

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

fun ammoutInserted ( ) : Int {
return i n s e r t e d C o i n s . sumOf { i t . typ e ∗ i t . cu r r en tC oun t } }

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

fun w r i t e F i l e ( ) {

37

50 | va l output = s t o r e d C o i n s . map { " $ { it . t y p e }; $ { it . c u r r e n t C o u n t } " }
51 | w r i t e F i l e ( f i l eN am e = " C o i n D e p o s i t . t x t " , dataArray = output . toTypedArray ( ) )
52 | }
53 | }
B.5 | Stations

### Algoritmo 6: Stations

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

### Algoritmo 7: File Access

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

38

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

39
