Apoll011/LIC-TicketMachine/KeyDecoderFSM.png

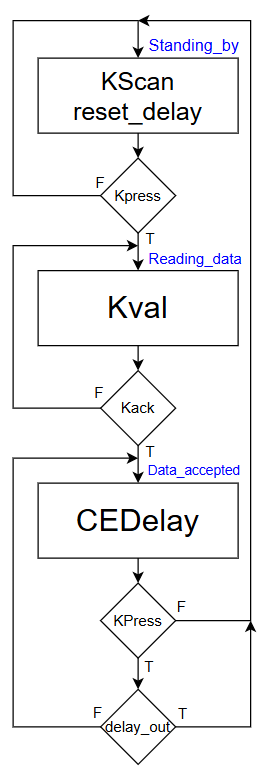
KeyDecoderFSM.png
