Apoll011/LIC-TicketMachine/KeyTransmitter_Control.png

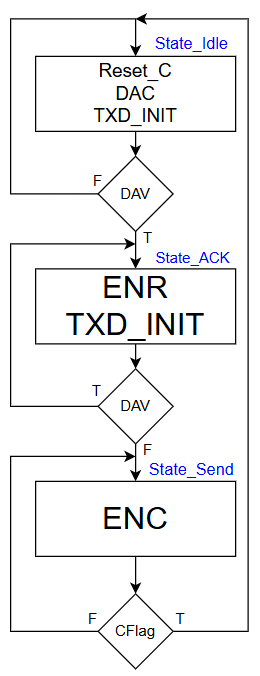
KeyTransmitter_Control.png
