Apoll011/LIC-TicketMachine/RBC.png

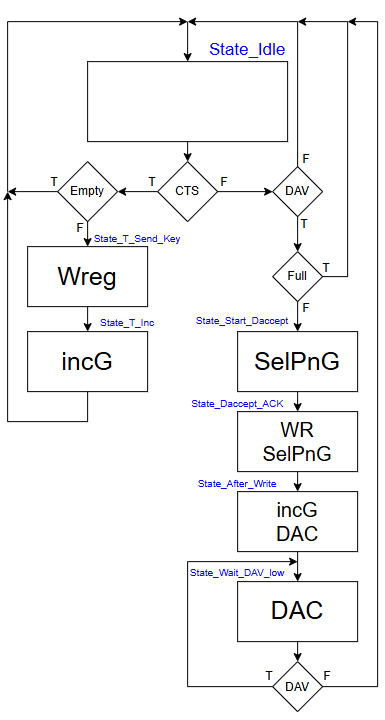
RBC.png
