Apoll011/LIC-TicketMachine/testbench/PELCD_tb.vhd

library ieee;
use ieee.std_logic_1164.all;

entity PELCD_tb is
end entity PELCD_tb;

architecture behavioral of PELCD_tb is

    component PELCD is
        port (
            SDX, CLK, SS, RESET : in  std_logic;
            Q                   : out std_logic_vector(9 downto 0)
        );
    end component PELCD;

    constant MCLK_PERIOD      : time := 20 ns;
    constant MCLK_HALF_PERIOD : time := MCLK_PERIOD / 2;

    signal reset_tb           : std_logic;
    signal clk_tb             : std_logic;
    signal SDX_tb             : std_logic;
    signal SS_tb              : std_logic;
    signal Q_tb               : std_logic_vector(9 downto 0);

begin

    UUT: component PELCD
    port map (
        RESET => reset_tb,
        CLK   => clk_tb,
        SDX   => SDX_tb,
        SS    => SS_tb,
        Q     => Q_tb
    );

    clk_gen: process
    begin
        clk_tb   <= '0';
        wait for MCLK_HALF_PERIOD;
        clk_tb   <= '1';
        wait for MCLK_HALF_PERIOD;
    end process clk_gen;

    stimulus: process
    begin
        reset_tb <= '1';
        SS_tb    <= '0';
        SDX_tb   <= '0';
        wait for MCLK_PERIOD * 6;

        reset_tb <= '0';
        wait for MCLK_PERIOD * 4;

        SS_tb    <= '0';
        wait for MCLK_PERIOD;
        SDX_tb   <= '1';
        wait for MCLK_PERIOD;
        SDX_tb   <= '0';
        wait for MCLK_PERIOD;
        SDX_tb   <= '1';
        wait for MCLK_PERIOD;
        SDX_tb   <= '0';
        wait for MCLK_PERIOD;
        SDX_tb   <= '1';
        wait for MCLK_PERIOD;
        SDX_tb   <= '0';
        wait for MCLK_PERIOD;
        SDX_tb   <= '1';
        wait for MCLK_PERIOD;
        SDX_tb   <= '0';
        wait for MCLK_PERIOD;
        SDX_tb   <= '1';
        wait for MCLK_PERIOD;
        SDX_tb   <= '0';
        wait for MCLK_PERIOD;
        SDX_tb   <= '0';
        SS_tb    <= '1';
        wait for MCLK_PERIOD * 2;
        SS_tb    <= '0';
        wait for MCLK_PERIOD;
        wait for MCLK_PERIOD * 4;

        SS_tb    <= '0';
        wait for MCLK_PERIOD;
        SDX_tb   <= '0';
        wait for MCLK_PERIOD;
        SDX_tb   <= '0';
        wait for MCLK_PERIOD;
        SDX_tb   <= '0';
        wait for MCLK_PERIOD;
        SDX_tb   <= '0';
        wait for MCLK_PERIOD;
        SDX_tb   <= '0';
        wait for MCLK_PERIOD;
        SDX_tb   <= '1';
        wait for MCLK_PERIOD;
        SDX_tb   <= '1';
        wait for MCLK_PERIOD;
        SDX_tb   <= '1';
        wait for MCLK_PERIOD;
        SDX_tb   <= '1';
        wait for MCLK_PERIOD;
        SDX_tb   <= '1';
        wait for MCLK_PERIOD;
        SDX_tb   <= '0';
        SS_tb    <= '1';
        wait for MCLK_PERIOD * 2;
        SS_tb    <= '0';
        wait for MCLK_PERIOD;
        wait for MCLK_PERIOD * 4;

        SS_tb    <= '0';
        wait for MCLK_PERIOD;
        SDX_tb   <= '1';
        wait for MCLK_PERIOD;
        SDX_tb   <= '0';
        wait for MCLK_PERIOD;
        SDX_tb   <= '0';
        wait for MCLK_PERIOD;
        SDX_tb   <= '0';
        wait for MCLK_PERIOD;
        SDX_tb   <= '0';
        wait for MCLK_PERIOD;
        SDX_tb   <= '0';
        wait for MCLK_PERIOD;
        SDX_tb   <= '0';
        wait for MCLK_PERIOD;
        SDX_tb   <= '0';
        wait for MCLK_PERIOD;
        SDX_tb   <= '0';
        wait for MCLK_PERIOD;
        SDX_tb   <= '1';
        wait for MCLK_PERIOD;
        SDX_tb   <= '0';
        SS_tb    <= '1';
        wait for MCLK_PERIOD * 2;
        SS_tb    <= '0';
        wait for MCLK_PERIOD;
        wait for MCLK_PERIOD * 4;

        SS_tb    <= '0';
        wait for MCLK_PERIOD;
        SDX_tb   <= '0';
        wait for MCLK_PERIOD;
        SDX_tb   <= '0';
        wait for MCLK_PERIOD;
        SDX_tb   <= '0';
        wait for MCLK_PERIOD;
        SDX_tb   <= '0';
        wait for MCLK_PERIOD;
        SDX_tb   <= '0';
        wait for MCLK_PERIOD;
        SDX_tb   <= '0';
        wait for MCLK_PERIOD;
        SDX_tb   <= '0';
        wait for MCLK_PERIOD;
        SDX_tb   <= '0';
        wait for MCLK_PERIOD;
        SDX_tb   <= '0';
        wait for MCLK_PERIOD;
        SDX_tb   <= '0';
        wait for MCLK_PERIOD;
        SDX_tb   <= '0';
        SS_tb    <= '1';
        wait for MCLK_PERIOD * 2;
        SS_tb    <= '0';
        wait for MCLK_PERIOD;
        wait for MCLK_PERIOD * 4;

        SS_tb    <= '0';
        wait for MCLK_PERIOD;
        SDX_tb   <= '1';
        wait for MCLK_PERIOD;
        SDX_tb   <= '1';
        wait for MCLK_PERIOD;
        SDX_tb   <= '1';
        wait for MCLK_PERIOD;
        SDX_tb   <= '1';
        wait for MCLK_PERIOD;
        SDX_tb   <= '1';
        wait for MCLK_PERIOD;
        SDX_tb   <= '1';
        wait for MCLK_PERIOD;
        SDX_tb   <= '1';
        wait for MCLK_PERIOD;
        SDX_tb   <= '1';
        wait for MCLK_PERIOD;
        SDX_tb   <= '1';
        wait for MCLK_PERIOD;
        SDX_tb   <= '1';
        wait for MCLK_PERIOD;
        SDX_tb   <= '0';
        SS_tb    <= '1';
        wait for MCLK_PERIOD * 2;
        SS_tb    <= '0';
        wait for MCLK_PERIOD;
        wait for MCLK_PERIOD * 4;

        SS_tb    <= '0';
        SDX_tb   <= '1';
        wait for MCLK_PERIOD * 4;
        reset_tb <= '1';
        wait for MCLK_PERIOD * 4;
        reset_tb <= '0';
        SS_tb    <= '0';
        SDX_tb   <= '0';
        wait for MCLK_PERIOD * 4;

        wait;
    end process stimulus;

end architecture behavioral;
