Apoll011/LIC-TicketMachine/KeyboardReader/Key_Decode.vhd

library ieee;
use ieee.std_logic_1164.all;

entity Key_Decode is
    port (
        Kack, RESET, CLK            : in  std_logic;
        Tdelay                      : in  std_logic_vector(1 downto 0);
        Kval, clk_out, clk_out_rise : out std_logic;
        K                           : out std_logic_vector(3 downto 0);
        Keys_Vertical               : out std_logic_vector(3 downto 0);
        Keys_Horizontal             : in  std_logic_vector(3 downto 0)
    );
end entity Key_Decode;

architecture logicFunction of Key_Decode is

    component Key_Control is
        port (
            CLK, RESET, Kack, Kpress           : in  std_logic;
            Tdelay                             : in  std_logic_vector(1 downto 0);
            Kval, Kscan, clk_out, clk_out_rise : out std_logic
        );
    end component Key_Control;

    component Key_Scan is
        port (
            Kscan, CLK, RESET : in  std_logic;
            Keys_Vertical     : out std_logic_vector(3 downto 0);
            Keys_Horizontal   : in  std_logic_vector(3 downto 0);
            K                 : out std_logic_vector(3 downto 0);
            Kpress            : out std_logic
        );
    end component Key_Scan;

    component CLKDIV is
        generic (
            div     :     natural := 50000000
        );
        port (
            clk_in  : in  std_logic;
            clk_out : out std_logic
        );
    end component CLKDIV;

    signal Kpress, Kscan, CLK_Divider : std_logic;

begin

    Clk_div: component CLKDIV
    generic map (
        div => 5000000 
    )
    port map (
        clk_in          => CLK,
        clk_out         => CLK_Divider -- 100ms, 10Hz
    );

    scan: component Key_Scan
    port map (
        RESET           => RESET,
        CLK             => CLK_Divider,
        Kscan           => Kscan,
        Kpress          => Kpress,
        K               => K,
        Keys_Vertical   => Keys_Vertical,
        Keys_Horizontal => Keys_Horizontal
    );

    control: component Key_Control
    port map (
        RESET           => RESET,
        CLK             => not CLK_Divider,
        Kpress          => Kpress,
        Kack            => Kack,
        Tdelay          => Tdelay,
        Kval            => Kval,
        Kscan           => Kscan,
        clk_out         => clk_out,
        clk_out_rise    => clk_out_rise
    );

end architecture logicFunction;
