Apoll011/LIC-TicketMachine/Common/sumador_binario.vhd

library IEEE;
use IEEE.std_logic_1164.all;

entity sumador_binario is

    port (
        A, B, Ci : in  std_logic;
        R        : out std_logic;
        Co       : out std_logic
    );
end entity sumador_binario;

architecture teste of sumador_binario is
begin

    R  <= A xor B xor Ci;

    Co <= (A and B) or (Ci and (A xor B));

end architecture teste;
