Apoll011/LIC-TicketMachine/(commit log)

2026-02-27 feat(keyboard): Add Key_Control component and integrate into TicketMachineAdds the `Key_Control` VHDL component to manage keyboard input and integrates it into the `TicketMachine` project. This inclu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
    [Key_Control.vhd, TicketMachine.vhd]
2026-02-27 refactor: Invert key press and vertical signals for clarity
    [Key_Scan.vhd]
2026-03-13 refactor(keydecoder): redesign state machine for key decoding
    [KeyDecoderFSM.vhd, Key_Control.vhd]
2026-03-20 feat(serial-receiver): add external reset capability
    [SerialReceiver.vhd, TicketMachine.vhd]
2026-03-27 feat(lcd): implement LCD serial driver and protocol
2026-04-01 Refactor pin assignments for clarity and organization
2026-05-15 Fix condition for state transition in KeyDecoderFSM
    [KeyDecoderFSM.vhd]
2026-05-22 Refactor TUI and LCD interfaces, add file handling for station data
    - Updated TUI.cursor to accept LCD.Line instead of Int for better type safety.
    - Introduced new methods in TUI for writing text and icons, and deleting text.
    - Modified LCD.cursor to use LCD.Line enum for line selection.
    - Changed station data format in stations.txt to use 0 for available tickets.
    - Created App class to initialize TUI and display current date and time.
    - Added FileAccess.kt for reading and writing station data to files.
    - Implemented Stations object to manage station data, including loading from file and updating ticket counts.
2026-05-22 refactor: remove debug print statement from readKey function
2026-05-22 refactor lcd custom icons to fixed slots
    Agent-Logs-Url: https://github.com/Apoll011/LIC-TicketMachine/sessions/2d052072-ab29-4329-bd55-b52f1b47e05d
2026-05-22 chore: simplifica carregamento de ícones no LCD
    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
2026-05-22 Clean up App.kt by removing commented sections
    Removed commented sections for screens, destination selection, payment flow, ticket collection, and display helpers.
2026-05-24 Add missing LCD and TicketDispenser testbenches
    Agent-Logs-Url: https://github.com/Apoll011/LIC-TicketMachine/sessions/9dbe3d0f-d2dd-4bbe-a7c9-5c7e719579b6
    [HoldRegister_tb.vhd, PELCD_tb.vhd, PETD_tb.vhd, ShiftRegister_tb.vhd, TICKET_DISPENSER_tb.vhd]
2026-05-24 Fix CoinAcceptor formatting and explicit bit mapping
    Agent-Logs-Url: https://github.com/Apoll011/LIC-TicketMachine/sessions/aa1b0e1d-997b-44bc-890e-1dd30c1cce3c
    [CoinAcceptor.vhd]
2026-05-29 Implement maintenance mode with multiple features
    Added maintenance mode with various functionalities including ticket printing, station and coin counters, system reset, and shutdown options.
